thaaraak/Tayloe-Mixer-v3/Tayloe-Mixer-v3.pdf

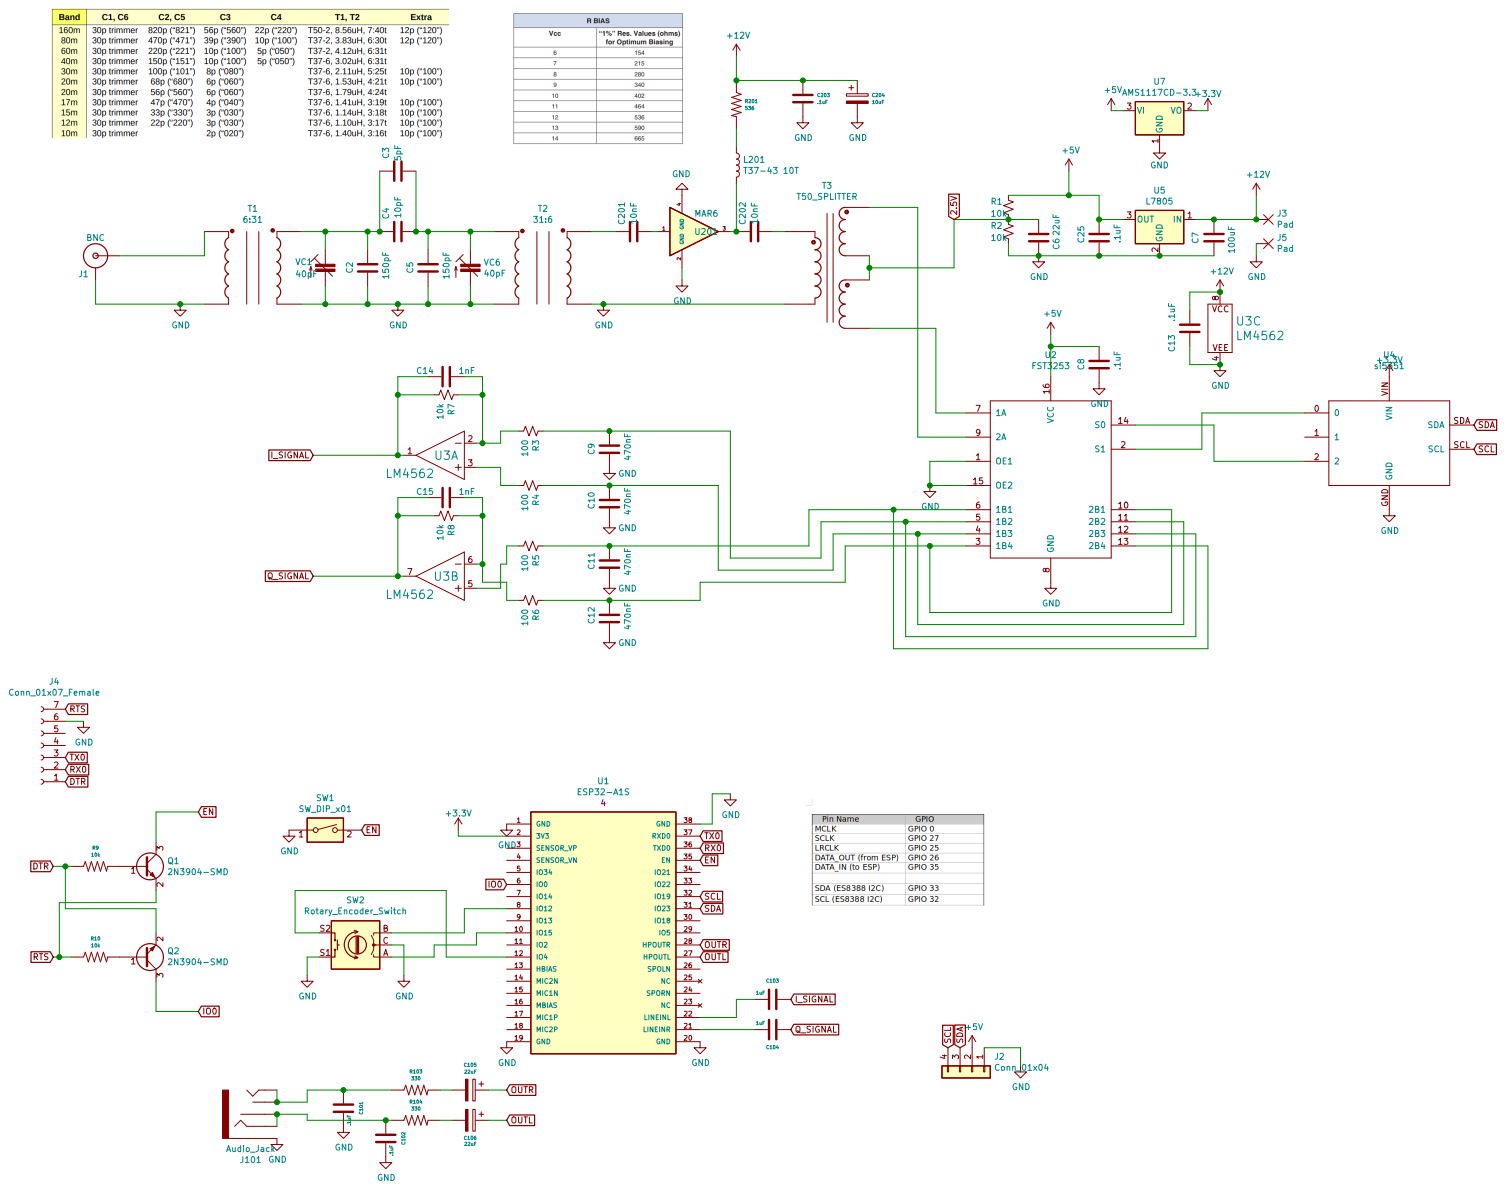
[picture p1: page 1]
