thaaraak/Tayloe-Mixer-v3/Tayloe-Mixer-v3.kicad_pcb

## KiCad design Tayloe-Mixer-v3.kicad_pcb (2022-11-04)

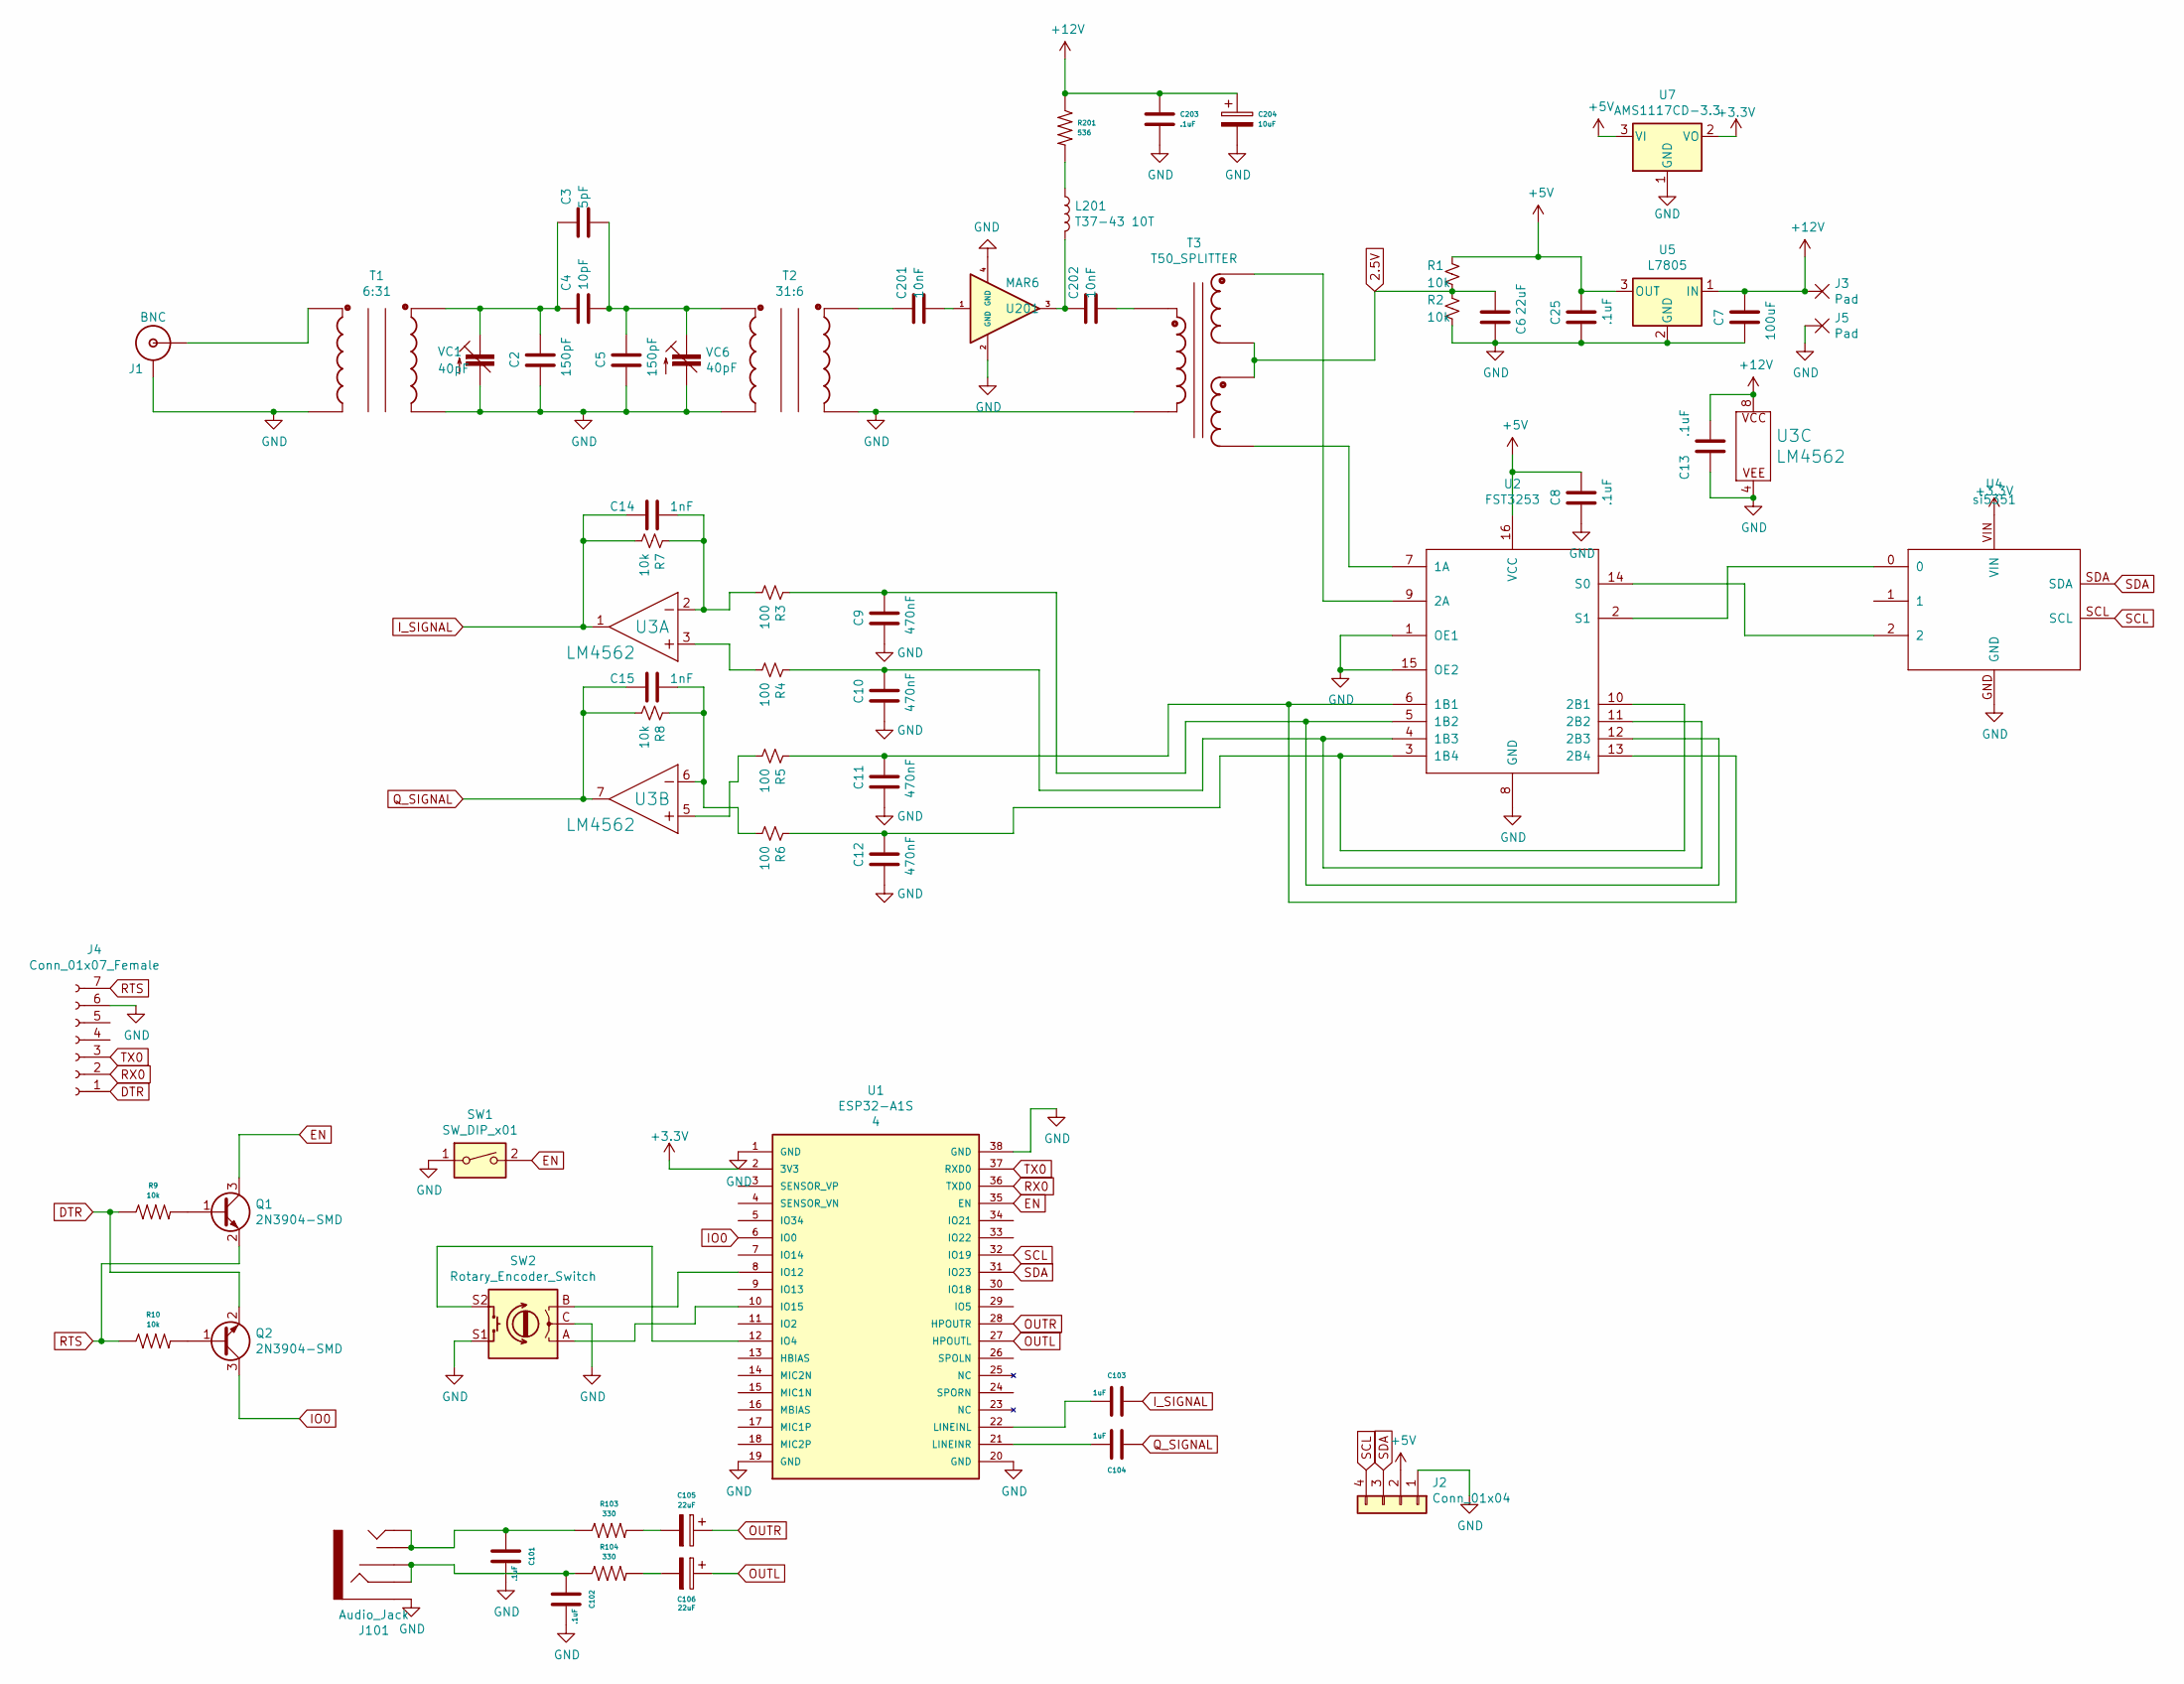
[picture p2: schematic Tayloe-Mixer-v3.sch]

Parts:
C2, C5: 150pF; Capacitor 1206
C3: 5pF; Capacitor 1206
C4: 10pF; Capacitor 1206
C6: 22uF; CP_Elec_4x5.4
C7: 100uF; CP_Elec_6.3x5.4
C8, C13, C25, C101, C102, C203: .1uF; Capacitor 1206
C9, C10, C11, C12: 470nF; Capacitor 0805
C14, C15: 1nF; Capacitor 0805
C103, C104: 1uF; Capacitor 1206
C105, C106: 22uF; Cap_4x5.4
C201, C202: 10nF; Capacitor 1206
C204: 10uF; Cap_4x5.4
J1: BNC
J2: Conn_01x04; PinSocket_1x04_P2.54mm_Vertical
J3, J5: Pad
J4: Conn_01x07_Female; PinSocket_1x07_P2.54mm_Vertical
J101: Audio_Jack
L201: T37-43 10T; T37_Inductor
Q1, Q2: 2N3904-SMD; SOT-23
R1, R2, R7, R8, R9, R10: 10k; Resistor 0805
R3, R4, R5, R6: 100; Resistor 0805
R103, R104: 330; Resistor 0805
R201: 536; Resistor 1206
SW1: SW_DIP_x01; SW_PUSH_6mm
SW2: Rotary_Encoder_Switch; RotaryEncoder_Alps_EC11E-Switch_Vertical_H20mm
T1: 6:31; T37 Transformer
T2: 31:6; T37 Transformer
T3: T50_SPLITTER; T50 Trifilar
U1: ESP32-A1S; PARTREV 4
U2: FST3253; SO16
U3: LM4562; SOIC8
U4: si5351
U5: L7805; TO-252-3_TabPin2
U7: AMS1117CD-3.3; SOT-223-3_TabPin2
U201: MAR6; VV105
VC1, VC6: 40pF; trimcap

Connections:
2.5V: C6.1, R1.2, R2.1, T3.C2A, T3.C3B
+3V3: U1.2 (3V3), U4.VIN, U7.2 (VO)
+5V: C8.2, C25.2, J2.2, R1.1, U2.16 (VCC), U5.3 (OUT), U7.3 (VI)
+12V: C7.1, C13.2, C203.1, C204.1, J3.1, R201.1, U3.8 (P$V+), U5.1 (IN)
DTR: J4.1, Q2.2 (E), R9.1
EN: Q1.3 (C), SW1.2, U1.35 (EN)
GND: C2.1, C5.1, C6.2, C7.2, C8.1, C9.1, C10.1, C11.1, C12.1, C13.1, C25.1, C101.2, C102.2, C203.2, C204.2, J1.GND, J2.1, J4.6, J5.1, J101.SLEEVE, R2.2, SW1.1, SW2.C, SW2.S1, T1.C1A, T1.C2A, T2.C1A, T2.C2A, T3.C1A, U1.1 (GND), U1.19 (GND), U1.20 (GND), U1.38 (GND), U2.1 (OE1), U2.8 (GND), U2.15 (OE2), U3.4 (P$V-), U4.GND, U5.2 (GND), U7.1 (GND), U201.2 (GND), U201.4 (GND), VC1.2 (A), VC6.2 (A)
IO0: Q2.3 (C), U1.6 (IO0)
I_SIGNAL: C14.1, C103.1, R7.2, U3.1 (OUT)
unnamed: C2.2, C3.1, C4.1, T1.C2B, VC1.1 (E)
unnamed: C3.2, C4.2, C5.2, T2.C1B, VC6.1 (E)
unnamed: C9.2, R3.1, U2.5 (1B2), U2.12 (2B3)
unnamed: C10.2, R4.1, U2.4 (1B3), U2.11 (2B2)
unnamed: C11.2, R5.1, U2.6 (1B1), U2.13 (2B4)
unnamed: C12.2, R6.1, U2.3 (1B4), U2.10 (2B1)
unnamed: C14.2, R3.2, R7.1, U3.2 (-IN)
unnamed: C15.2, R6.2, R8.1, U3.6 (-IN)
unnamed: C101.1, J101.TIP, J101.TSH, R103.1
unnamed: C102.1, J101.RING, J101.RSH, R104.1
unnamed: C103.2, U1.22 (LINEINL)
unnamed: C104.2, U1.21 (LINEINR)
unnamed: C105.2, R103.2
unnamed: C106.2, R104.2
unnamed: C201.1, T2.C2B
unnamed: C201.2, U201.1
unnamed: C202.1, L201.2, U201.3
unnamed: C202.2, T3.C1B
unnamed: J1.S (OUT), T1.C1B
unnamed: L201.1, R201.2
unnamed: Q1.1 (B), R9.2
unnamed: Q2.1 (B), R10.2
unnamed: R4.2, U3.3 (+IN)
unnamed: R5.2, U3.5 (+IN)
unnamed: SW2.A, U1.10 (IO15)
unnamed: SW2.B, U1.8 (IO12)
unnamed: SW2.S2, U1.12 (IO4)
unnamed: T3.C2B, U2.9 (2A)
unnamed: T3.C3A, U2.7 (1A)
unnamed: U2.2 (S1), U4.0
unnamed: U2.14 (S0), U4.2
OUTL: C106.1, U1.27 (HPOUTL)
OUTR: C105.1, U1.28 (HPOUTR)
Q_SIGNAL: C15.1, C104.1, R8.2, U3.7 (OUT)
RTS: J4.7, Q1.2 (E), R10.1
RX0: J4.2, U1.36 (TXD0)
SCL: J2.4, U1.32 (IO19), U4.SCL
SDA: J2.3, U1.31 (IO23), U4.SDA
TX0: J4.3, U1.37 (RXD0)

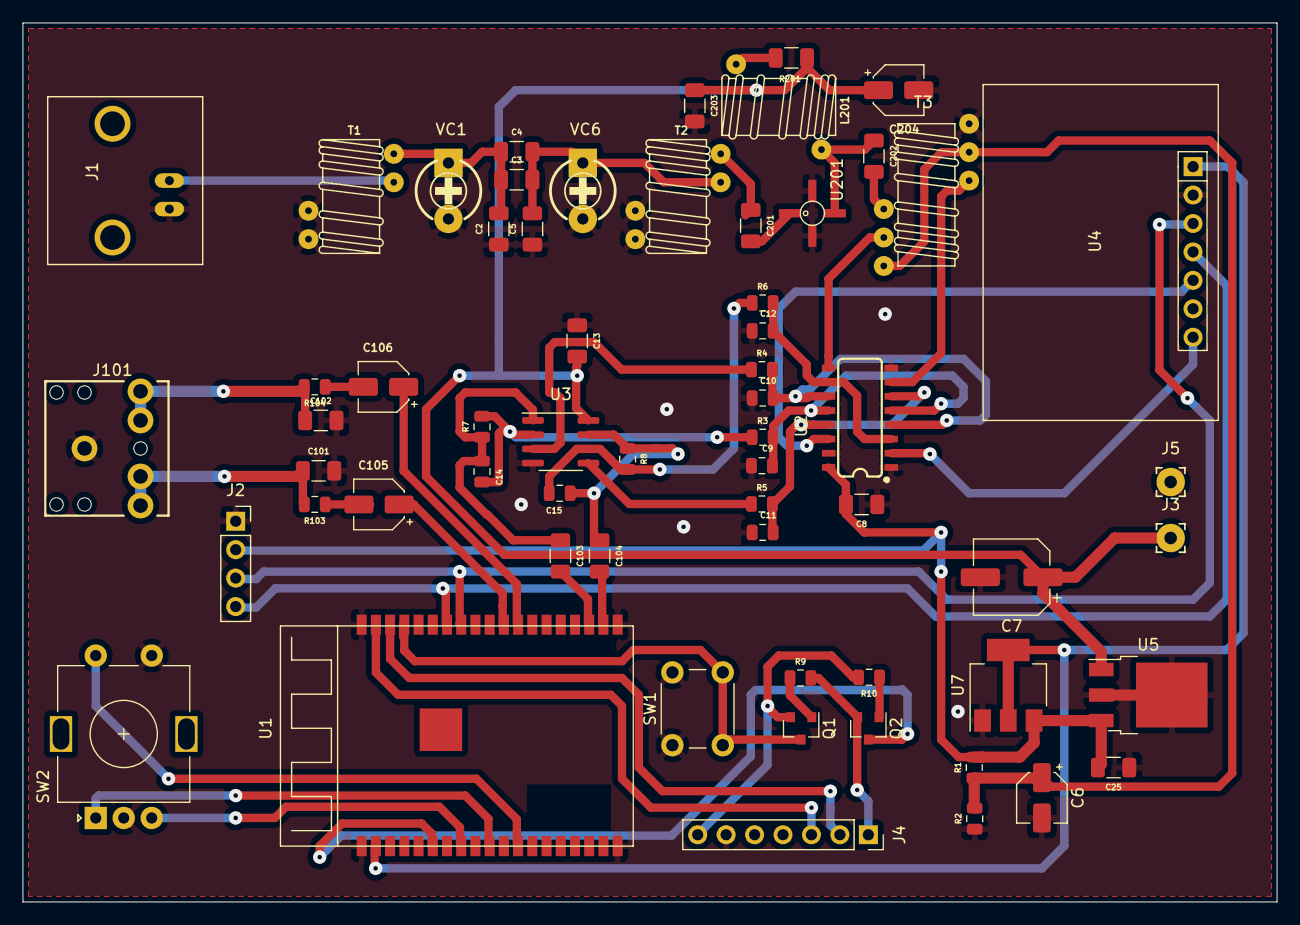
[picture p3: board Tayloe-Mixer-v3.kicad_pcb from above]

Board: 2 copper layers, 112.0 x 78.5 mm, 61 parts (0 on the bottom side), 48 nets.
