thaaraak/Tayloe-Mixer-v3/(commit log)

2022-10-03 added esp32
    [Tayloe-Mixer-v3.sch]
2022-10-03 finished footprints
    [Tayloe-Mixer-v3.sch]
2022-10-03 updated pcb
    [Tayloe-Mixer-v3.sch]
2022-10-17 updating pcb
    [Tayloe-Mixer-v3.kicad_pcb, Tayloe-Mixer-v3.sch]
2022-10-18 fixed audio jack
    [Tayloe-Mixer-v3.kicad_pcb, Tayloe-Mixer-v3.sch]
2022-10-18 added gerber
    [Tayloe-Mixer-v3-B_Cu.gbl, Tayloe-Mixer-v3-B_Mask.gbs, Tayloe-Mixer-v3-B_Paste.gbp, Tayloe-Mixer-v3-B_SilkS.gbo, Tayloe-Mixer-v3-Edge_Cuts.gm1, Tayloe-Mixer-v3-F_Cu.gtl, Tayloe-Mixer-v3-F_Mask.gts, Tayloe-Mixer-v3-F_Paste.gtp]
2022-10-21 fixed rx/tx
    [Tayloe-Mixer-v3.kicad_pcb, Tayloe-Mixer-v3.sch]
2022-10-24 added keepout area under esp32
    [Tayloe-Mixer-v3.kicad_pcb]
2022-10-27 moved bpf
    [Tayloe-Mixer-v3.kicad_pcb]
